Alvazz/Valenok/README.md

# Valenok
Zubax Valenok is a middle-power ESC for BLDC motors
