Alvazz/Valenok/src/cap_pcb.brd

## EAGLE design src/cap_pcb.brd (2020-12-03)

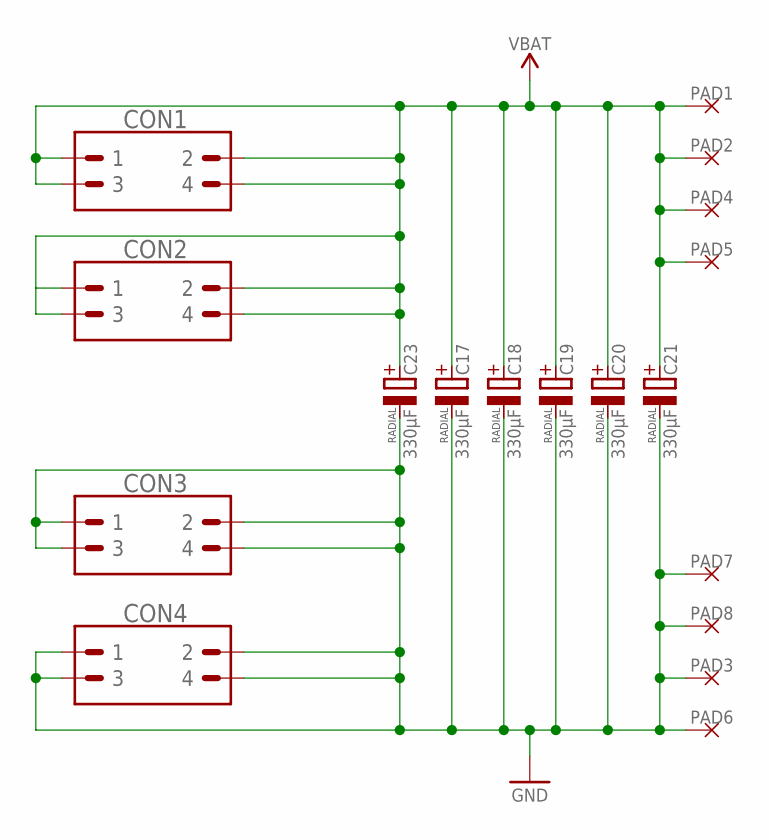
[picture p3: schematic cap_pcb.sch, Power]

Parts:
C17, C18, C19, C20, C21, C23: 330µF; RADIAL_SIDE_12.5X22; VOLTAGE 160V; DIGIKEY# 493-4784-3-ND
CON1, CON2, CON3, CON4: PINHEAD_2X02-PTH-2.54-MALE; 2X02-PTH-2.54
PAD1, PAD2, PAD3, PAD4, PAD5, PAD6, PAD7, PAD8: PAD-5X4; 5X4

Connections:
GND: C17.-, C18.-, C19.-, C20.-, C21.-, C23.-, CON3.1, CON3.2, CON3.3, CON3.4, CON4.1, CON4.2, CON4.3, CON4.4, PAD3.P$1, PAD6.P$1, PAD7.P$1, PAD8.P$1
VBAT: C17.+, C18.+, C19.+, C20.+, C21.+, C23.+, CON1.1, CON1.2, CON1.3, CON1.4, CON2.1, CON2.2, CON2.3, CON2.4, PAD1.P$1, PAD2.P$1, PAD4.P$1, PAD5.P$1

Board: 2 copper layers, 20 parts (11 on the bottom side), 2 nets, no tracks yet.

Other parts of the board:
U$1, U$3: ZUBAX_20X9
