Alvazz/Valenok/src/connectors.brd

## EAGLE design src/connectors.brd (2020-12-03)

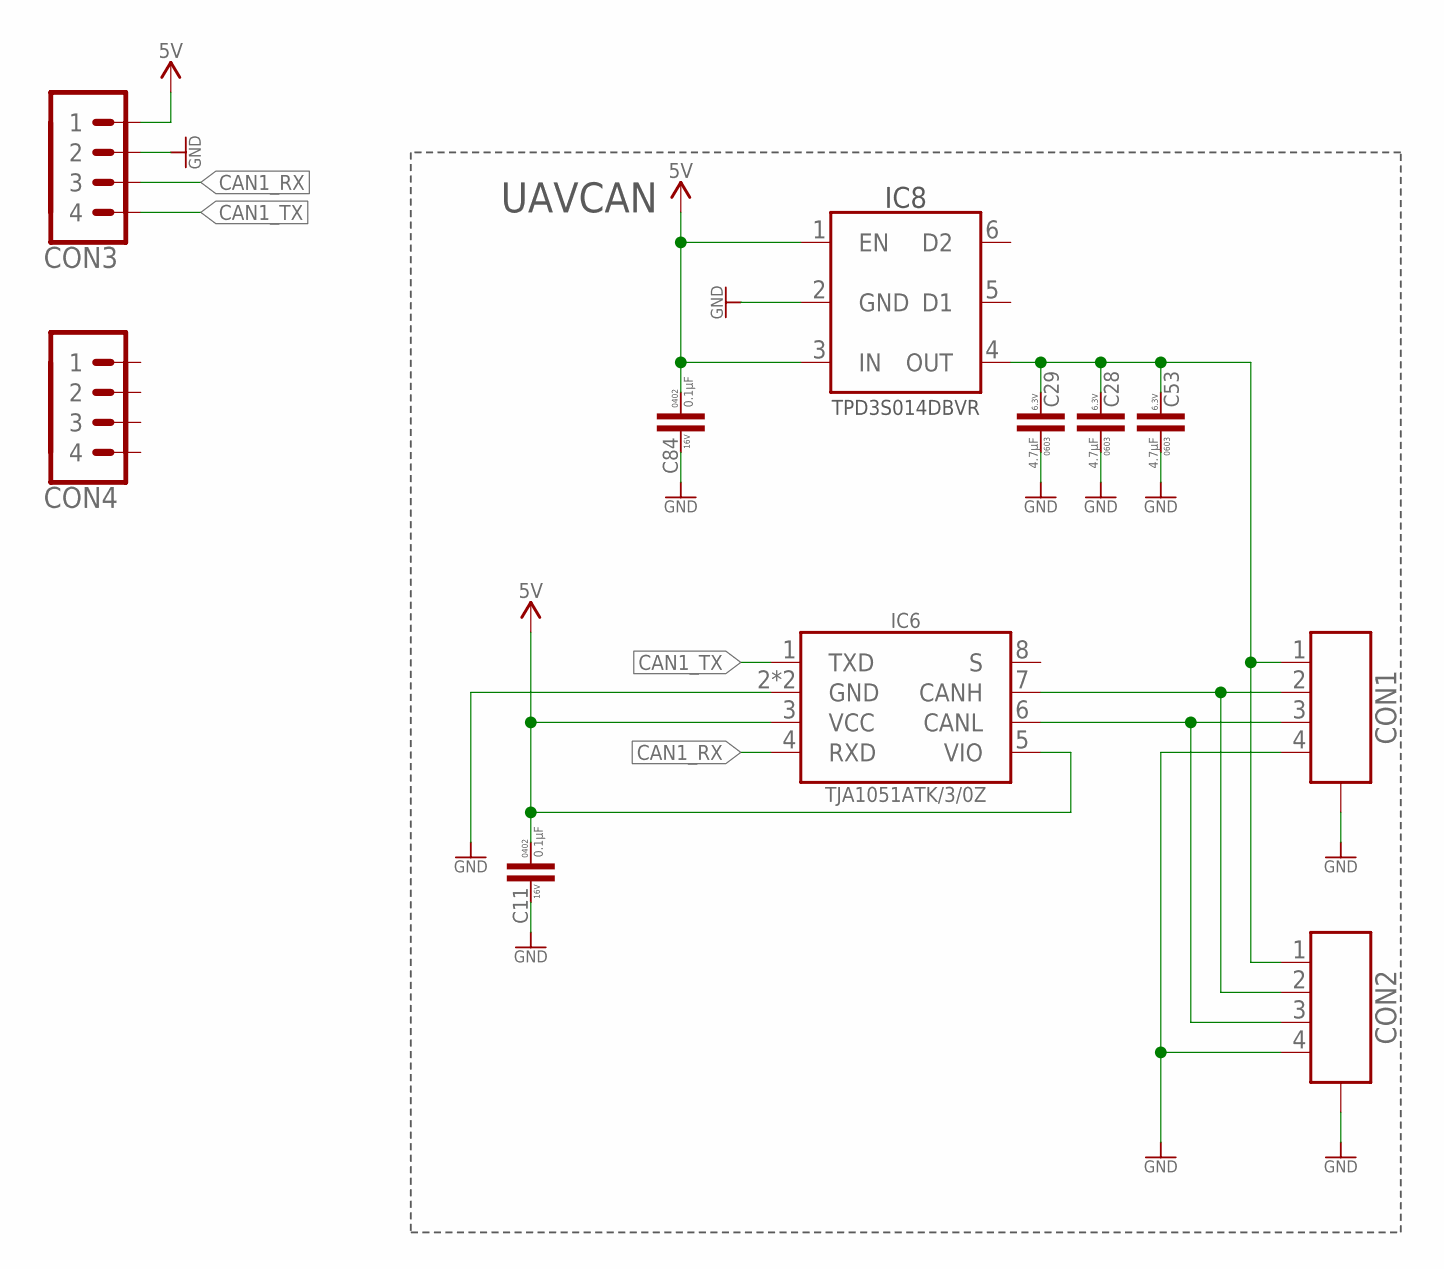
[picture p4: schematic connectors.sch]

Parts:
C11, C84: 0.1µF; C0402; VOLTAGE 16V; DIGIKEY# 490-3261-1-ND
C28, C29, C53: 4.7µF; C0603; VOLTAGE 6.3V; DIGIKEY# 1276-2087-1-ND
CON1, CON2: CON-4P-TABS-JST_GH-RA; JST_GH-4P-RA
CON3, CON4: PINHEAD_1X04-2-FEMALE; 1X04-PTH-2-FEMALE
IC6: TJA1051-HVSON8; SOT782-1
IC8: TPD3S014DBVR-SOT23-6; SOT26

Connections:
CAN1_RX: CON3.3, IC6.4 (RXD)
CAN1_TX: CON3.4, IC6.1 (TXD)
CAN1_VDD: C28.2, C29.2, C53.2, CON1.1, CON2.1, IC8.4 (OUT)
GND: C11.2, C28.1, C29.1, C53.1, C84.2, CON1.4, CON1.M$0 (GND), CON1.M$1 (GND), CON2.4, CON2.M$0 (GND), CON2.M$1 (GND), CON3.2, IC6.2 (GND), IC6.PAD (GND), IC8.2 (GND)
unnamed: CON1.2, CON2.2, IC6.7 (CANH)
unnamed: CON1.3, CON2.3, IC6.6 (CANL)
VDD_5V: C11.1, C84.1, CON3.1, IC6.3 (VCC), IC6.5 (VIO), IC8.1 (EN), IC8.3 (IN)

Notes on the sheet:
UAVCAN

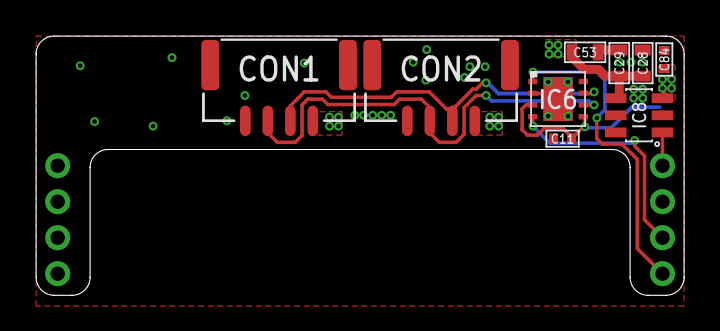
[picture p5: board connectors.brd from above]

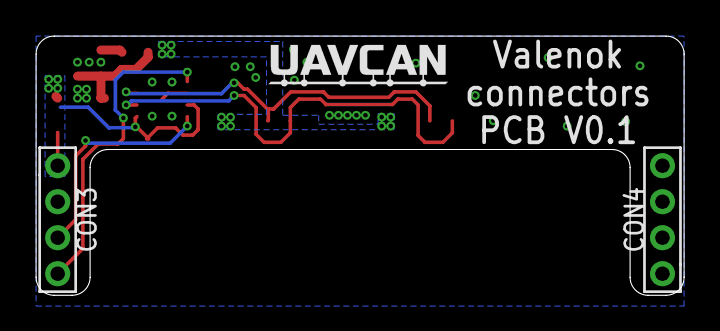
[picture p6: board connectors.brd from below]

Board: 2 copper layers, 36.0 x 14.4 mm, 12 parts (3 on the bottom side), 7 nets.

Other parts of the board:
U$1: UAVCAN_10X3
