Alvazz/Valenok/src/power.brd

## EAGLE design src/power.brd (2020-12-03)

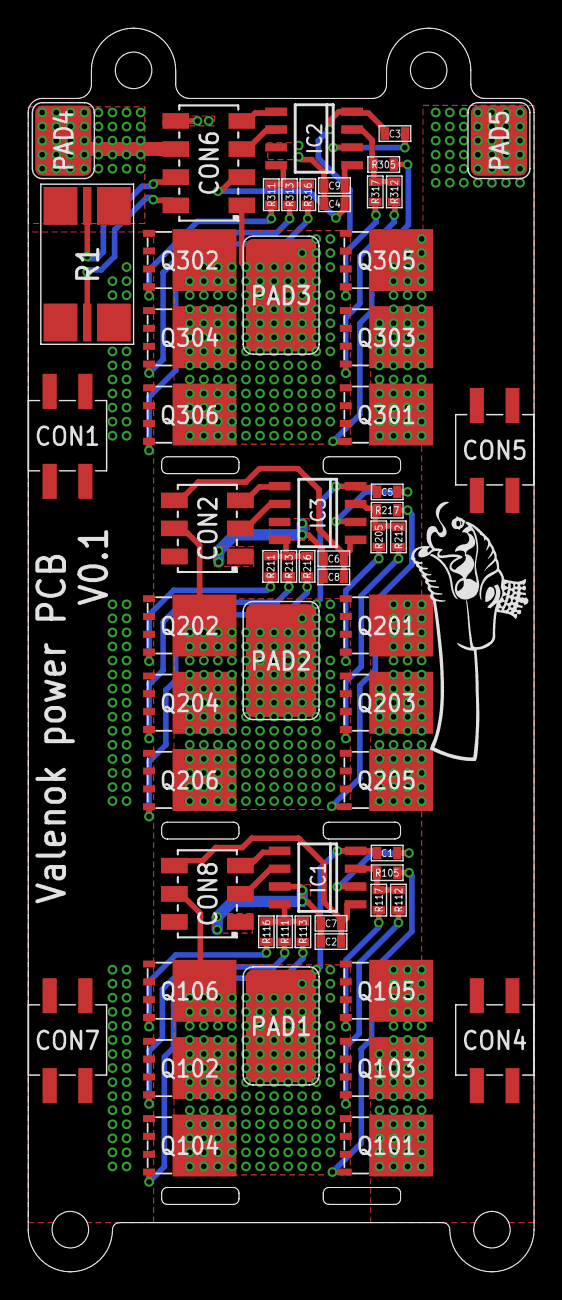
[picture p7: board power.brd from above]

Board: 2 copper layers, 36.0 x 88.5 mm, 62 parts (0 on the bottom side), 45 nets.

Parts:
C1, C2, C3, C4, C5, C6: 0.1uF; C0603
C7, C8, C9: 1000pF; C0603
CON1, CON4, CON5, CON7: PINHEAD_2X02-SMD-2.54-MALE; PINHEAD_2X02_SMD_MALE_2.54
CON2, CON8: PINHEAD_2X03-0877590614; 2X03-SMD-2-MALE
CON6: PINHEAD_2X04-SMD-2-MALE; 2X04-SMD-2-MALE
IC1, IC2, IC3: UCC27282-SOIC8; SOIC8
PAD1, PAD2, PAD3: PAD-5X8; 5X8
PAD4, PAD5: PAD-5X4; 5X4
Q101, Q102, Q103, Q104, Q105, Q106, Q201, Q202, Q203, Q204, Q205, Q206, Q301, Q302, Q303, Q304, Q305, Q306: BSC077N12NS3GATMA1; PG-TDSON-8-1
R1: 200 µOhms; R3920-KELVIN
R105, R111, R112, R113, R116, R117, R205, R211, R212, R213, R216, R217, R305, R311, R312, R313, R316, R317: 4R3; R0603
U$1: DRAGON-18X7

Connections:
97: C2.1, C7.1, CON8.6, IC1.1
A_GH: IC1.3, R105.1, R112.1, R117.1
A_GL: IC1.8, R111.1, R113.1, R116.1
A_IH: CON8.5, IC1.5
A_IL: CON8.3, IC1.6
A_PH: C1.2, CON8.4, IC1.4, PAD1.P$1, Q101.1, Q101.2, Q101.3, Q102.P$1, Q103.1, Q103.2, Q103.3, Q104.P$1, Q105.1, Q105.2, Q105.3, Q106.P$1
B_GH: IC3.3, R205.1, R212.1, R217.1
B_GL: IC3.8, R211.1, R213.1, R216.1
B_IH: CON2.5, IC3.5
B_IL: CON2.3, IC3.6
B_PH: C5.2, CON2.4, IC3.4, PAD2.P$1, Q201.1, Q201.2, Q201.3, Q202.P$1, Q203.1, Q203.2, Q203.3, Q204.P$1, Q205.1, Q205.2, Q205.3, Q206.P$1
CS+: CON6.2, R1.S2
CS-: CON6.4, R1.S1
C_GH: IC2.3, R305.1, R312.1, R317.1
C_GL: IC2.8, R311.1, R313.1, R316.1
C_IH: CON6.7, IC2.5
C_IL: CON6.5, IC2.6
C_PH: C3.2, CON6.1, IC2.4, PAD3.P$1, Q301.1, Q301.2, Q301.3, Q302.P$1, Q303.1, Q303.2, Q303.3, Q304.P$1, Q305.1, Q305.2, Q305.3, Q306.P$1
GND: C2.2, C6.2, C7.2, C8.2, CON2.1, CON8.1, IC1.7, IC3.7
unnamed: C3.1, IC2.2
unnamed: C5.1, IC3.2
unnamed: C4.1, C9.1, CON6.3, IC2.1
unnamed: C6.1, C8.1, CON2.6, IC3.1
unnamed: C1.1, IC1.2
PGND: CON1.1, CON1.2, CON1.3, CON1.4, CON7.1, CON7.2, CON7.3, CON7.4, Q102.1, Q102.2, Q102.3, Q104.1, Q104.2, Q104.3, Q106.1, Q106.2, Q106.3, Q202.1, Q202.2, Q202.3, Q204.1, Q204.2, Q204.3, Q206.1, Q206.2, Q206.3, Q302.1, Q302.2, Q302.3, Q304.1, Q304.2, Q304.3, Q306.1, Q306.2, Q306.3, R1.2, R1.22
PHASE_A:N$1: Q101.4, R105.2
PHASE_A:N$2: Q102.4, R111.2
PHASE_A:N$3: Q103.4, R112.2
PHASE_A:N$4: Q104.4, R113.2
PHASE_A:N$5: Q105.4, R117.2
PHASE_A:N$6: Q106.4, R116.2
PHASE_B:N$1: Q201.4, R205.2
PHASE_B:N$2: Q202.4, R211.2
PHASE_B:N$3: Q203.4, R212.2
PHASE_B:N$4: Q204.4, R213.2
PHASE_B:N$5: Q205.4, R217.2
PHASE_B:N$6: Q206.4, R216.2
PHASE_C:N$1: Q301.4, R305.2
PHASE_C:N$2: Q302.4, R311.2
PHASE_C:N$3: Q303.4, R312.2
PHASE_C:N$4: Q304.4, R313.2
PHASE_C:N$5: Q305.4, R317.2
PHASE_C:N$6: Q306.4, R316.2
VBAT-: C4.2, C9.2, CON6.6, IC2.7, PAD4.P$1, R1.1, R1.11
VDC: CON4.1, CON4.2, CON4.3, CON4.4, CON5.1, CON5.2, CON5.3, CON5.4, CON6.8, PAD5.P$1, Q101.P$1, Q103.P$1, Q105.P$1, Q201.P$1, Q203.P$1, Q205.P$1, Q301.P$1, Q303.P$1, Q305.P$1
