Alvazz/Valenok/src/logic.brd

## EAGLE design src/logic.brd (2020-12-03)

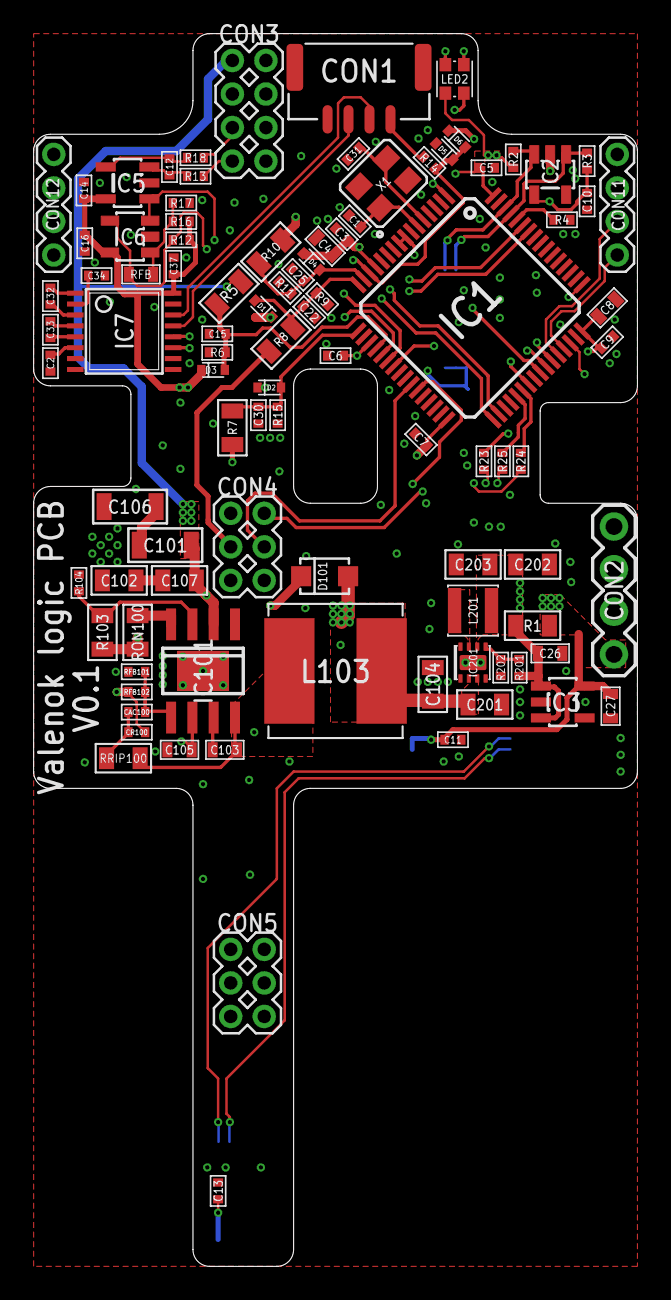
[picture p8: board logic.brd from above]

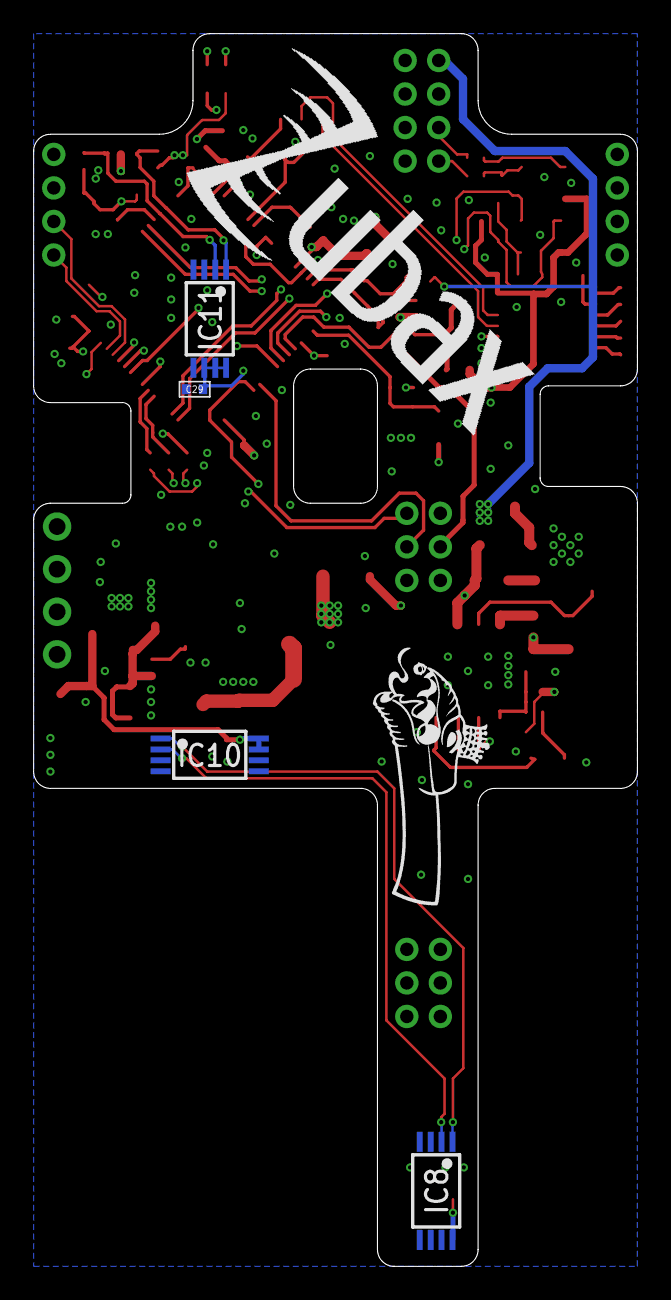
[picture p9: board logic.brd from below]

Board: 4 copper layers, 36.0 x 73.5 mm, 100 parts (6 on the bottom side), 65 nets.

Parts:
C1, C31: 9pF; C0402
C2, C5, C6, C7, C9, C10, C11, C13, C14, C16, C29, C32, C33, C34, C37: 0.1µF; C0402
C3: 10nF; C0402
C4, C26, C105: 1µF; C0603
C8, C27: 4.7µF; C0603
C12: 1000pF; C0402
C15, C22, C25, C30: 4700pF; C0402
C101, C106: 4.7µF; C1206
C102, C107: 1µF; C0805
C103: 0.01uF; C0603
C104, C201, C202, C203: 10uF; C0805
CAC100: 0.1uF; C0402
CON1: CON-4P-TABS-JST_GH-RA; JST_GH-4P-RA
CON2: PINHEAD_1X04-2.54; 1X04-PTH-2.54
CON3: PINHEAD_2X04-PLS-2; 2X04-PTH-2
CON4, CON5: PINHEAD_2X03-PTH-2; 2X03-PTH-2
CON11, CON12: PINHEAD_1X04-2; 1X04-PTH-2
CR100: 3300pF; C0402
D1, D2, D3, D4, D5, D6: BAT54KFILM; SOD523
D101: PMEG4020; SOD123F
IC1: STM32F105RCT6; TQFP64
IC2: CAT24C02; SOT23-5L
IC3: AP2127-3.3; SOT23-5
IC5: INA180A2; SOT23-5
IC6: LMV331; SOT23-5L
IC7: ST3232; TSSOP16
IC8, IC10, IC11: LM75-TSSOP8; TSSOP8
IC101: LM5017; SOIC8-POWERPAD
IC201: TPS62160QDSGRQ1; WFDFN-8
L103: 120µH; HPC8040NF
L201: 2.2µH; NR3015
LED2: LED_RGB-2020; LED2020
R1: DNM; R0805
R2, R3, R4: 3K9; R0402
R5: 110K; R0805
R6, R16: 3K3; R0402
R7, R8, R10: 51K; R0805
R9, R11, R15: 1K8; R0402
R12, R17: 5K6; R0402
R13, R18: 000; R0402
R14, R23, R24, R25: 200R; R0402
R103: 127K; R0805
R104: 14K; R0402
R201: 51K; R0402
R202: 10K; R0402
RFB: DNM; R0603
RFB101: 1K; R0402
RFB102: 10K; R0402
RON100: 110K; R0805
RRIP100: 110K; R0805
U$1: DRAGON-15X6
U$2: ZUBAX_25X12
X1: 16MHz; OSCILLATOR-3.2X2.5-4P

Connections:
BOOT0: IC1.60, R4.2
CAN1_RX: CON11.3, IC1.44
CAN1_TX: CON11.4, IC1.45
CAN2_RX: CON12.3, IC1.33
CAN2_TX: CON12.4, IC1.34
CS+: C12.1, IC5.3, R13.1
CS-: C12.2, IC5.4, R18.1
CURRENT_AMP_OUT: IC1.21, IC5.1, IC6.3
FET_A_H: CON3.2, IC1.41
FET_A_L: CON3.4, IC1.23
FET_B_H: CON4.2, IC1.42
FET_B_L: CON4.4, IC1.26
FET_C_H: CON5.2, IC1.43
FET_C_L: CON5.4, IC1.27
GND: C1.1, C2.2, C3.1, C4.1, C5.1, C6.1, C7.1, C8.2, C9.2, C10.2, C11.2, C13.2, C14.2, C15.1, C16.1, C22.1, C25.1, C26.1, C27.1, C29.2, C30.1, C31.1, C34.2, C37.1, C102.1, C104.1, C105.1, C106.P$1, C201.1, C202.1, C203.1, CON1.4, CON1.M$0, CON1.M$1, CON2.3, CON3.3, CON4.5, CON4.6, CON5.5, CON5.6, CON11.2, CON12.2, D5.A, IC1.10, IC1.11, IC1.12, IC1.18, IC1.31, IC1.47, IC1.63, IC2.2, IC3.2, IC5.2, IC6.2, IC7.15, IC8.4, IC8.5, IC8.6, IC8.7, IC10.4, IC10.5, IC10.6, IC11.4, IC11.5, IC101.1, IC101.P$1, IC201.1, IC201.4, IC201.EP, R4.1, R6.1, R9.1, R11.1, R15.1, R17.2, R104.1, R202.1, RFB101.1, X1.2, X1.4
HV_DC-DC(LM5017):N$1: C101.P$1, C106.P$2
HV_DC-DC(LM5017):N$2: C103.2, IC101.8, L103.1, RRIP100.2
HV_DC-DC(LM5017):N$3: CAC100.2, CR100.2, RRIP100.1
HV_DC-DC(LM5017):N$4: C102.2, C107.1
HV_DC-DC(LM5017):N$10: C105.2, D101.C, IC101.6
HV_DC-DC(LM5017):N$11: IC101.4, RON100.2
HV_DC-DC(LM5017):N$12: C103.1, IC101.7
HV_DC-DC(LM5017):N$14: CAC100.1, IC101.5, RFB101.2, RFB102.1
HV_DC-DC(LM5017):N$17: IC101.3, R103.1, R104.2
I2C_SCL: IC1.61, IC2.1, IC8.2, IC10.2, IC11.2, R3.2
I2C_SDA: IC1.62, IC2.3, IC8.1, IC10.1, IC11.1, R2.2
LV_DC-DC:FB: IC201.5, R201.1, R202.2
LV_DC-DC:N$1: IC201.7, L201.1
unnamed: CON3.7, R13.2
unnamed: CON1.1, R14.1
unnamed: IC1.37, R25.2
unnamed: CON3.5, R18.2
unnamed: LED2.B, R23.1
unnamed: LED2.R, R25.1
unnamed: IC1.38, R24.2
unnamed: C31.2, IC1.5, X1.3
unnamed: IC1.39, R23.2
unnamed: C32.1, IC7.1
unnamed: C32.2, IC7.3
unnamed: C1.2, IC1.6, X1.1
unnamed: C33.1, IC7.5
unnamed: C33.2, IC7.4
unnamed: LED2.G, R24.1
unnamed: C2.1, IC7.6
unnamed: C34.1, IC7.2
unnamed: CON1.3, IC7.13
unnamed: CON1.2, IC7.14
OVERCURRENT_FAULT: IC1.22, IC6.4, R12.2, RFB.1
PHASE_A: CON3.8, R10.1
PHASE_B: CON4.3, R8.1
PHASE_C: CON5.3, R7.1
RC_PWM: CON12.1, D5.C, D6.A, IC1.14, R14.2
SENSE_A: C25.2, D4.A, IC1.15, R10.2, R11.2
SENSE_B: C22.2, D1.A, IC1.16, R8.2, R9.2
SENSE_C: C30.2, D2.A, IC1.17, R7.2, R15.2
SENSE_VIN: C15.2, D3.A, IC1.20, R5.1, R6.2
SWCLK: CON2.2, IC1.49
SWDIO: CON2.1, IC1.46
USART1_RX: IC1.59, IC7.12
USART1_TX: IC1.58, IC7.11
VDC: C101.P$2, C107.2, CON3.1, IC101.2, R5.2, R103.2, RON100.1
VDD_3V3: C3.2, C4.2, C5.2, C6.2, C7.2, C8.1, C9.1, C10.1, C11.1, C13.1, C14.1, C16.2, C27.2, C29.1, C37.2, CON2.4, D1.C, D2.C, D3.C, D4.C, IC1.1, IC1.8, IC1.9, IC1.13, IC1.19, IC1.32, IC1.48, IC1.64, IC2.4, IC3.5, IC5.5, IC6.5, IC7.16, IC8.8, IC10.7, IC10.8, IC11.6, IC11.7, IC11.8, LED2.+, R1.2, R2.1, R3.1, R12.1, R16.2
VDD_5V: C26.2, C202.2, C203.2, CON11.1, D6.C, IC3.1, IC3.3, IC201.6, L201.2, R1.1, R201.2
VDD_12V: C104.2, C201.2, CON3.6, CON4.1, CON5.1, CR100.1, D101.A, IC201.2, IC201.3, L103.2, RFB102.2
VREF: IC6.1, R16.1, R17.1, RFB.2
