Alvazz/Valenok/(commit log)

2020-10-09 initial import
    [cable_clip.brd, connectors.brd, connectors.sch, logic.brd, logic.sch, power.brd, power.sch]
2020-10-16 attribute updates
    [logic.brd, logic.sch]
2020-10-20 Update and rename high-level requirements.md to high-level_requirements.md
    Добавил требования надёжности, внёс несколько малозначимых изменений в раздел про интерфейсы, поправил форматирование и пунктуацию.
2020-10-22 Power supply scheme rearrangement
    [logic.brd, logic.sch]
2020-10-23 HV dc-dc update
    [logic.brd, logic.sch]
2020-10-23 Attributes extension
    [power.brd, power.sch]
2020-10-26 Update high-level_requirements.md
    UART => RS-485/232
2020-10-28 Connectors update
    [logic.brd, logic.sch]
2020-10-29 Components placement
    [logic.brd, logic.sch]
2020-10-29 outline update
    [logic.brd]
2020-11-02 Updates here and there
    [cap_pcb.brd, cap_pcb.sch, connectors.brd, logic.brd, logic.sch, power.brd, power.sch]
2020-11-04 routing upodates
    [logic.brd, logic.sch]
2020-11-05 Currennt measurement update
    [logic.brd, logic.sch, power.brd, power.sch]
2020-11-05 experimental digital pot added
    [logic.brd, logic.sch]
2020-11-05 bigger connector PCB connectors
    [logic.brd, logic.sch]
2020-11-09 logic pcb routing done
    [logic.brd, logic.sch]
2020-11-10 connectors PCB routing effort
    [connectors.brd, connectors.sch, logic.brd, power.brd]
2020-11-10 connectors pcb adjustments
    [connectors.brd, connectors.sch]
2020-11-13 rearrangement and alternate power stage design added
    [cable_clip.brd, cap_pcb.brd, cap_pcb.sch, connectors.brd, connectors.sch, logic.brd, logic.sch, power.brd]
2020-11-13 Minor updates
    [connectors.brd, logic.brd, logic.sch]
2020-11-13 variant A updates
    [connectors.brd, logic.brd, logic.sch]
2020-11-13 Remove version A
    [cable_clip.brd, cap_pcb.brd, cap_pcb.sch, connectors.brd, connectors.sch, logic.brd, logic.sch, power.brd]
2020-11-16 BEMF sensig nets updates
    [logic.brd, logic.sch]
2020-11-16 capacitor PCB polygons update
    [cap_pcb.brd, cap_pcb.sch]
2020-11-16 Current amplifier input filtering added
    [logic.brd, logic.sch]
2020-11-16 Logic PCB updates
    [logic.brd, logic.sch]
2020-11-16 Logos added
    [logic.brd]
2020-11-16 Connectors PCB UAVCAN logo added
    [connectors.brd]
2020-11-16 Power PCB update
    DRC errors resolvinnng
    [power.brd, power.sch]
2020-11-16 Silkscreen updates
    [logic.brd, power.brd]
2020-11-16 Values of the current amp filter updated
    [logic.brd, logic.sch]
2020-11-17 phase sensing nominals updated
    [logic.brd, logic.sch]
2020-11-17 Phase sensing filter update
    [logic.brd, logic.sch]
2020-11-17 BEMF filter update
    [logic.brd, logic.sch]
2020-11-19 massibe attribute updates everywhere
    [logic.brd, logic.sch, power.brd, power.sch]
2020-11-19 Minor attribute tweaks
    [logic.brd, logic.sch]
2020-11-19 minor fix
    [logic.brd, logic.sch]
2020-11-20 HV Capacitors optimizations
    [logic.brd, logic.sch]
2020-11-20 Interpcb connectors updated. Ground problem solved
    [cap_pcb.brd, logic.brd, logic.sch, power.brd, power.sch]
2020-11-20 Slots update
    [cap_pcb.brd]
2020-11-20 attributes update
    [logic.brd, logic.sch]
2020-11-23 RC PWM updated
    [logic.brd, logic.sch]
2020-11-23 Crystal attributes update
    [logic.brd, logic.sch]
2020-11-24 Massive routing update
    InterPCB connectors between Cap PCB and power PCB replaced with bigger ones
    [cap_pcb.brd, cap_pcb.sch, logic.brd, power.brd, power.sch]
2020-11-25 DC-DC design notes update
    [logic.brd, logic.sch]
2020-11-25 Notes added
    [logic.brd, logic.sch]
2020-11-25 assembly variant fix
    [cap_pcb.brd, cap_pcb.sch]
2020-11-25 Update logic.brd
    Minor outline correction
    [logic.brd]
2020-11-25 assembly variant update
    [connectors.brd, connectors.sch]
2020-11-25 Outline updates to allow debug assembly with connectors
    [cap_pcb.brd, connectors.brd, connectors.sch]
2020-11-25 Connectors PCB pinheaders updated
    [logic.brd, logic.sch]
2020-12-03 Minor tweaks here and there for better manufacturability
    [cable_clip.brd, cap_pcb.brd, cap_pcb.sch, connectors.brd, connectors.sch, logic.brd, logic.sch, power.brd]
